nkien0204/hand_gesture/report/Linh-kiện.xlsx

Tên linh kiện | Giá (nghìn đ) | Link | Số lượng
Cảm biến flex | 1900 | https://nshopvn.com/product/cam-bien-uon-cong-flex-sensor/ | 5
Arduino Atmega2560 | 180 | https://banlinhkien.shop/arduino-mega2560 | 1
Thẻ nhớ Micro SD 16GB | 135 | https://banlinhkien.vn/goods-6777--vn-the-nho-microsd-16g-class10-80mb-s-chinh-hang.html | 1
Module ghi đọc thẻ Micro | 14 | https://mualinhkien.vn/module-micro-sd-card | 1
Tổng | 2229
